solderdemon/rosco_m68k-ramboard/design/roscram01.kicad_pcb

## KiCad design design/roscram01.kicad_pcb (2026-10-20)

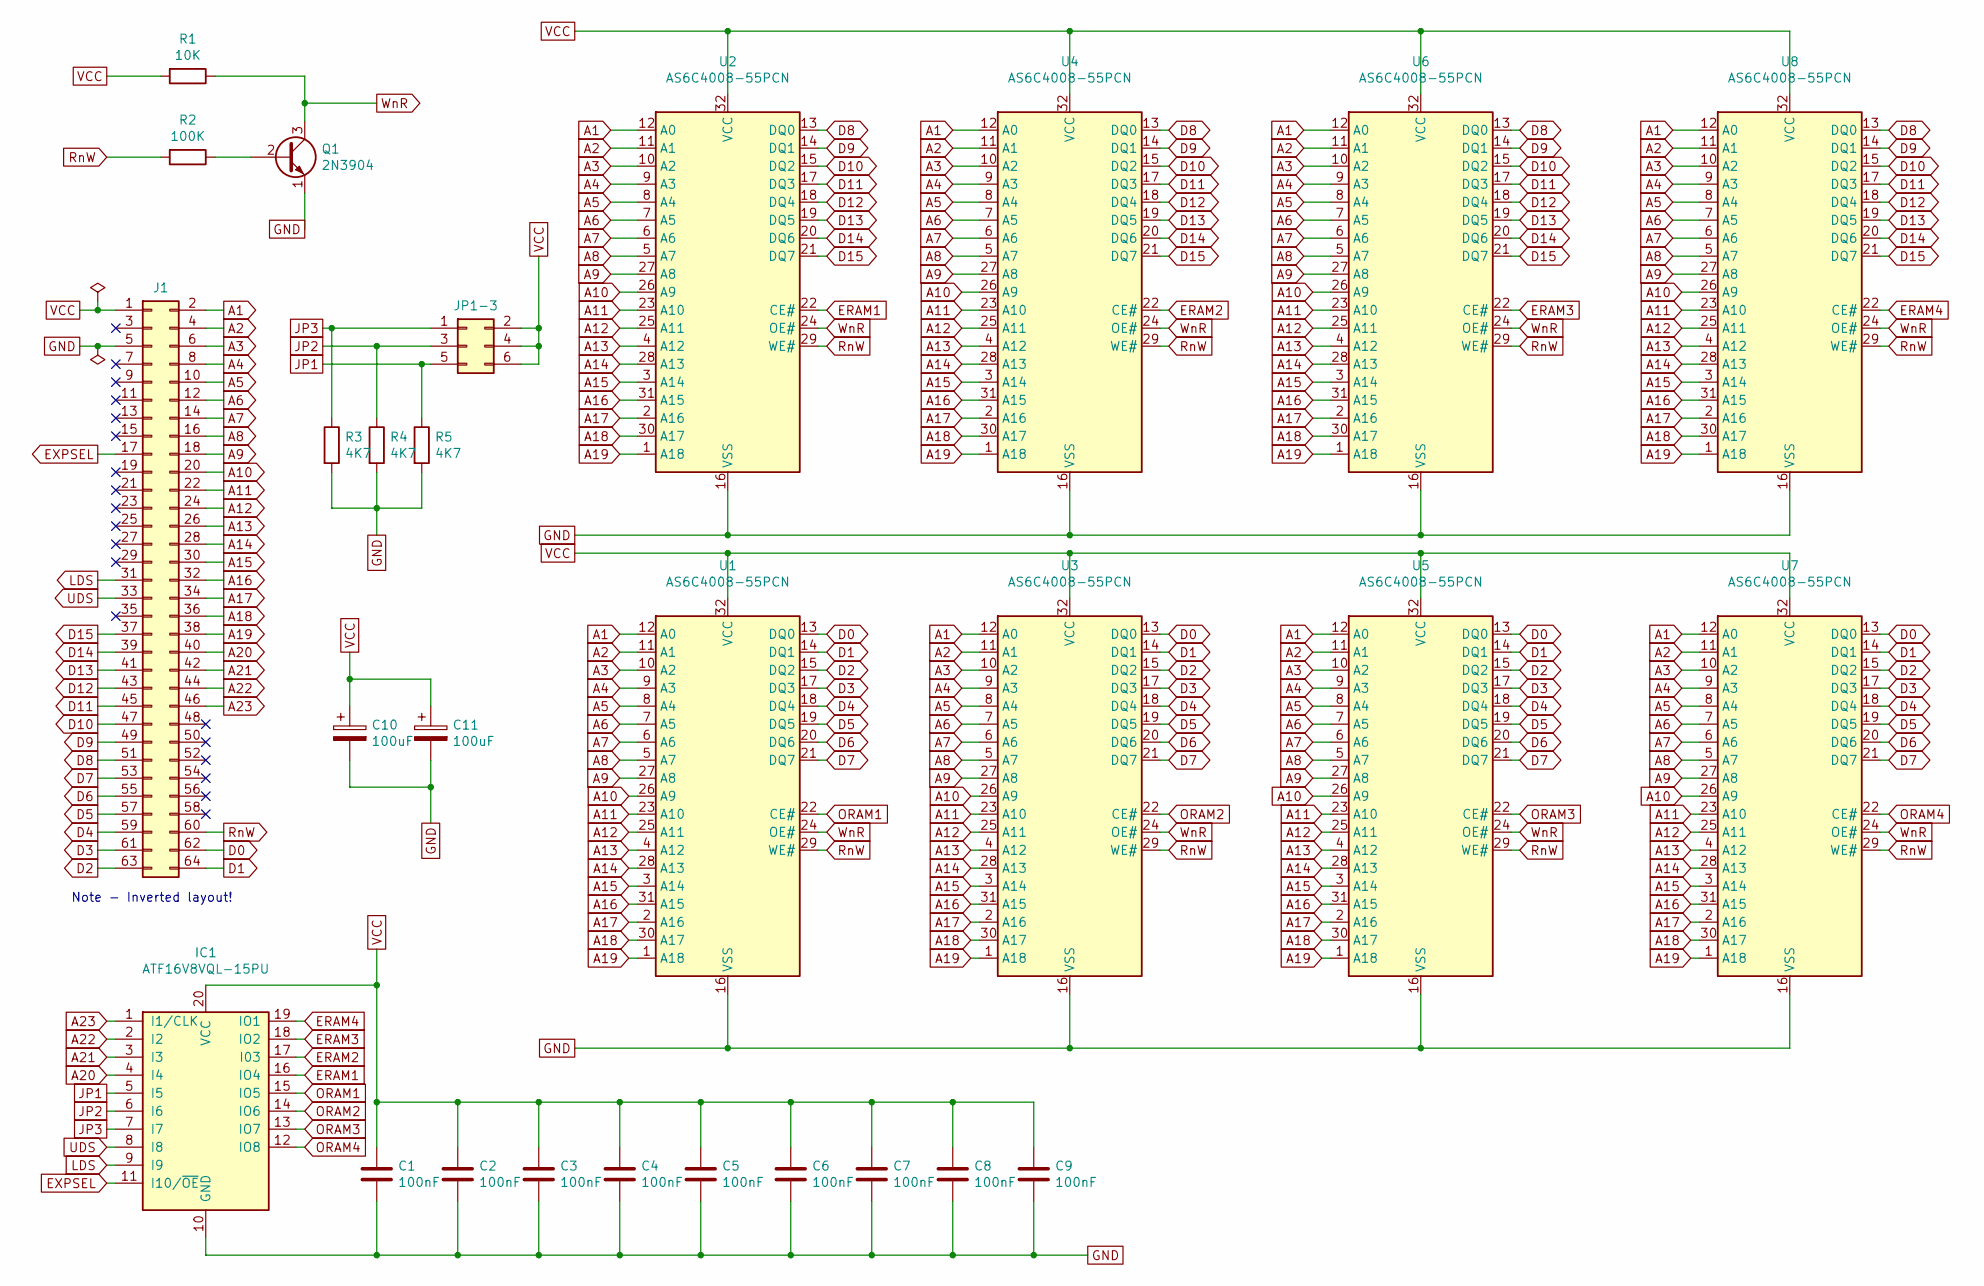
[picture p2: schematic roscram01.sch, rosco_m68k RAM expansion 1]

Parts:
C1, C2, C3, C4, C5, C6, C7, C8, C9: 100nF; C_Radial_5.08mm
C10, C11: 100uF; C-Electolytic-2,5-5
IC1: ATF16V8VQL-15PU; DIL20
J1: Conn_02x32_Odd_Even; pin-2X32
JP1-3: Conn_02x03_Odd_Even; pin-2X3
Q1: 2N3904; TO-92_Inline
R1: 10K; R-0207_10
R2: 100K; R-0207_10
R3, R4, R5: 4K7; R-0207_10
U1, U2, U3, U4, U5, U6, U7, U8: AS6C4008-55PCN; DIP-32_W15.24mm

Connections:
A1: J1.2, U1.12 (A0), U2.12 (A0), U3.12 (A0), U4.12 (A0), U5.12 (A0), U6.12 (A0), U7.12 (A0), U8.12 (A0)
A2: J1.4, U1.11 (A1), U2.11 (A1), U3.11 (A1), U4.11 (A1), U5.11 (A1), U6.11 (A1), U7.11 (A1), U8.11 (A1)
A3: J1.6, U1.10 (A2), U2.10 (A2), U3.10 (A2), U4.10 (A2), U5.10 (A2), U6.10 (A2), U7.10 (A2), U8.10 (A2)
A4: J1.8, U1.9 (A3), U2.9 (A3), U3.9 (A3), U4.9 (A3), U5.9 (A3), U6.9 (A3), U7.9 (A3), U8.9 (A3)
A5: J1.10, U1.8 (A4), U2.8 (A4), U3.8 (A4), U4.8 (A4), U5.8 (A4), U6.8 (A4), U7.8 (A4), U8.8 (A4)
A6: J1.12, U1.7 (A5), U2.7 (A5), U3.7 (A5), U4.7 (A5), U5.7 (A5), U6.7 (A5), U7.7 (A5), U8.7 (A5)
A7: J1.14, U1.6 (A6), U2.6 (A6), U3.6 (A6), U4.6 (A6), U5.6 (A6), U6.6 (A6), U7.6 (A6), U8.6 (A6)
A8: J1.16, U1.5 (A7), U2.5 (A7), U3.5 (A7), U4.5 (A7), U5.5 (A7), U6.5 (A7), U7.5 (A7), U8.5 (A7)
A9: J1.18, U1.27 (A8), U2.27 (A8), U3.27 (A8), U4.27 (A8), U5.27 (A8), U6.27 (A8), U7.27 (A8), U8.27 (A8)
A10: J1.20, U1.26 (A9), U2.26 (A9), U3.26 (A9), U4.26 (A9), U5.26 (A9), U6.26 (A9), U7.26 (A9), U8.26 (A9)
A11: J1.22, U1.23 (A10), U2.23 (A10), U3.23 (A10), U4.23 (A10), U5.23 (A10), U6.23 (A10), U7.23 (A10), U8.23 (A10)
A12: J1.24, U1.25 (A11), U2.25 (A11), U3.25 (A11), U4.25 (A11), U5.25 (A11), U6.25 (A11), U7.25 (A11), U8.25 (A11)
A13: J1.26, U1.4 (A12), U2.4 (A12), U3.4 (A12), U4.4 (A12), U5.4 (A12), U6.4 (A12), U7.4 (A12), U8.4 (A12)
A14: J1.28, U1.28 (A13), U2.28 (A13), U3.28 (A13), U4.28 (A13), U5.28 (A13), U6.28 (A13), U7.28 (A13), U8.28 (A13)
A15: J1.30, U1.3 (A14), U2.3 (A14), U3.3 (A14), U4.3 (A14), U5.3 (A14), U6.3 (A14), U7.3 (A14), U8.3 (A14)
A16: J1.32, U1.31 (A15), U2.31 (A15), U3.31 (A15), U4.31 (A15), U5.31 (A15), U6.31 (A15), U7.31 (A15), U8.31 (A15)
A17: J1.34, U1.2 (A16), U2.2 (A16), U3.2 (A16), U4.2 (A16), U5.2 (A16), U6.2 (A16), U7.2 (A16), U8.2 (A16)
A18: J1.36, U1.30 (A17), U2.30 (A17), U3.30 (A17), U4.30 (A17), U5.30 (A17), U6.30 (A17), U7.30 (A17), U8.30 (A17)
A19: J1.38, U1.1 (A18), U2.1 (A18), U3.1 (A18), U4.1 (A18), U5.1 (A18), U6.1 (A18), U7.1 (A18), U8.1 (A18)
A20: IC1.4 (I4), J1.40
A21: IC1.3 (I3), J1.42
A22: IC1.2 (I2), J1.44
A23: IC1.1 (I1/CLK), J1.46
D0: J1.62, U1.13 (DQ0), U3.13 (DQ0), U5.13 (DQ0), U7.13 (DQ0)
D1: J1.64, U1.14 (DQ1), U3.14 (DQ1), U5.14 (DQ1), U7.14 (DQ1)
D2: J1.63, U1.15 (DQ2), U3.15 (DQ2), U5.15 (DQ2), U7.15 (DQ2)
D3: J1.61, U1.17 (DQ3), U3.17 (DQ3), U5.17 (DQ3), U7.17 (DQ3)
D4: J1.59, U1.18 (DQ4), U3.18 (DQ4), U5.18 (DQ4), U7.18 (DQ4)
D5: J1.57, U1.19 (DQ5), U3.19 (DQ5), U5.19 (DQ5), U7.19 (DQ5)
D6: J1.55, U1.20 (DQ6), U3.20 (DQ6), U5.20 (DQ6), U7.20 (DQ6)
D7: J1.53, U1.21 (DQ7), U3.21 (DQ7), U5.21 (DQ7), U7.21 (DQ7)
D8: J1.51, U2.13 (DQ0), U4.13 (DQ0), U6.13 (DQ0), U8.13 (DQ0)
D9: J1.49, U2.14 (DQ1), U4.14 (DQ1), U6.14 (DQ1), U8.14 (DQ1)
D10: J1.47, U2.15 (DQ2), U4.15 (DQ2), U6.15 (DQ2), U8.15 (DQ2)
D11: J1.45, U2.17 (DQ3), U4.17 (DQ3), U6.17 (DQ3), U8.17 (DQ3)
D12: J1.43, U2.18 (DQ4), U4.18 (DQ4), U6.18 (DQ4), U8.18 (DQ4)
D13: J1.41, U2.19 (DQ5), U4.19 (DQ5), U6.19 (DQ5), U8.19 (DQ5)
D14: J1.39, U2.20 (DQ6), U4.20 (DQ6), U6.20 (DQ6), U8.20 (DQ6)
D15: J1.37, U2.21 (DQ7), U4.21 (DQ7), U6.21 (DQ7), U8.21 (DQ7)
ERAM1: IC1.16 (IO4), U2.22 (CE#)
ERAM2: IC1.17 (I03), U4.22 (CE#)
ERAM3: IC1.18 (IO2), U6.22 (CE#)
ERAM4: IC1.19 (IO1), U8.22 (CE#)
EXPSEL: IC1.11 (I10/~OE~), J1.17
JP1: IC1.5 (I5), JP1-3.5, R5.1
JP2: IC1.6 (I6), JP1-3.3, R4.1
JP3: IC1.7 (I7), JP1-3.1, R3.1
LDS: IC1.9 (I9), J1.31
unnamed: Q1.2 (B), R2.1
ORAM1: IC1.15 (IO5), U1.22 (CE#)
ORAM2: IC1.14 (IO6), U3.22 (CE#)
ORAM3: IC1.13 (IO7), U5.22 (CE#)
ORAM4: IC1.12 (IO8), U7.22 (CE#)
RnW: J1.60, R2.2, U1.29 (WE#), U2.29 (WE#), U3.29 (WE#), U4.29 (WE#), U5.29 (WE#), U6.29 (WE#), U7.29 (WE#), U8.29 (WE#)
UDS: IC1.8 (I8), J1.33
WnR: Q1.3 (C), R1.1, U1.24 (OE#), U2.24 (OE#), U3.24 (OE#), U4.24 (OE#), U5.24 (OE#), U6.24 (OE#), U7.24 (OE#), U8.24 (OE#)

Notes on the sheet:
Note - Inverted layout!

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
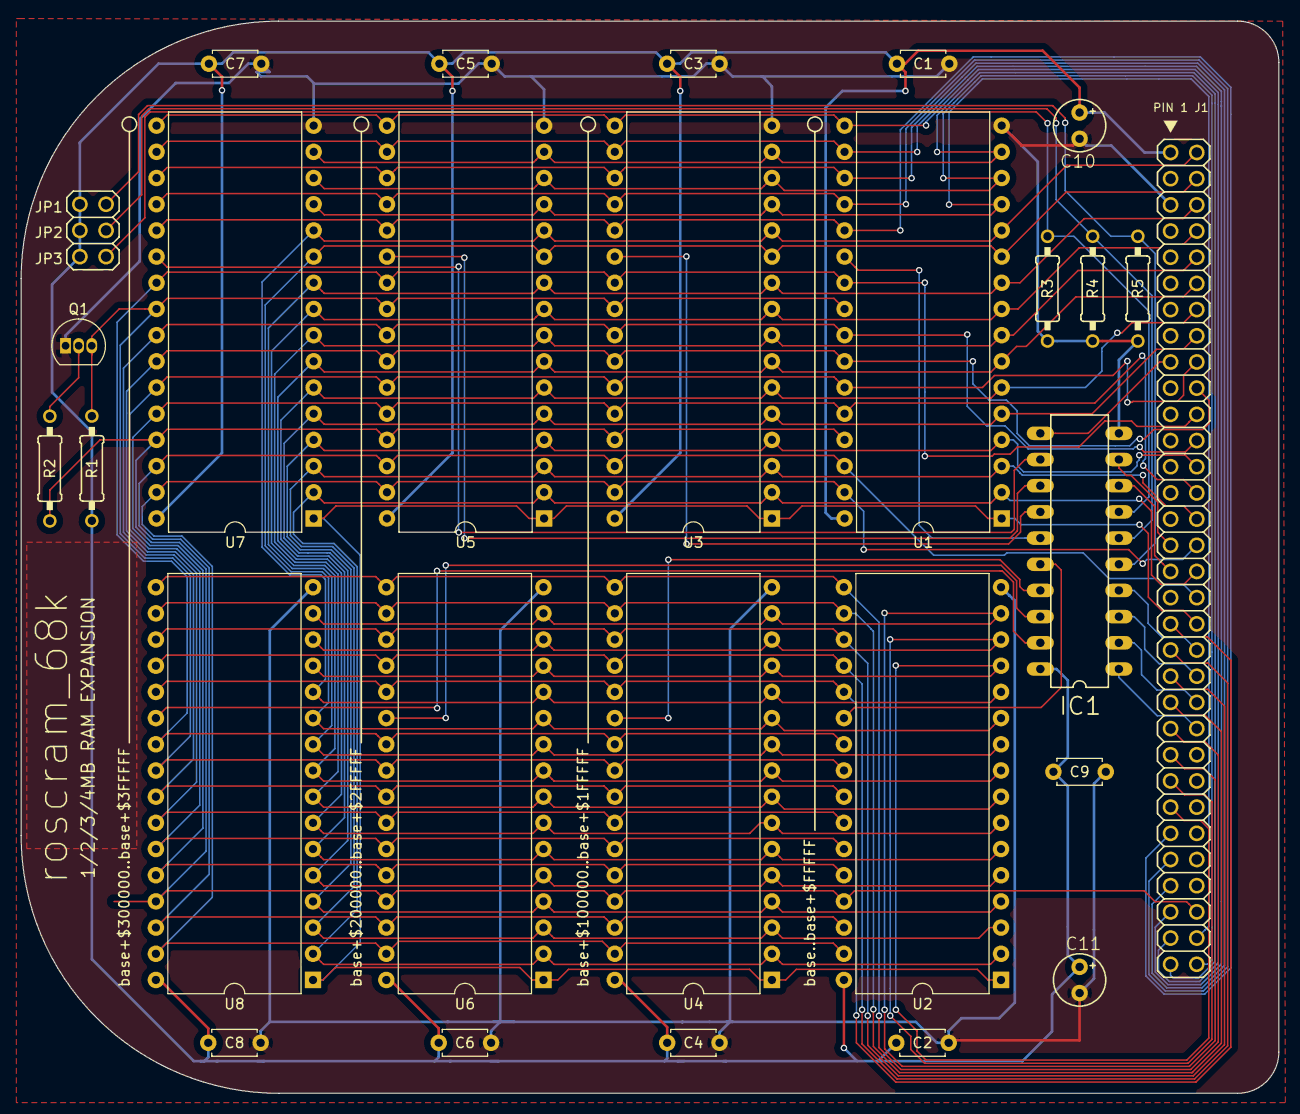
[picture p3: board roscram01.kicad_pcb from above]

Board: 2 copper layers, 122.0 x 104.0 mm, 28 parts (0 on the bottom side), 58 nets.
