solderdemon/rosco_m68k-ramboard/(commit log)

2026-10-20 roscram-01 RAM expansion, SolderDemon revision r1
    Upstream roscram-01 (rosco-m68k/hardware-projects, CERN OHL v1.2) with the
    board brought in line with the SolderDemon m68k cards:
    - nine 100 nF capacitors on the 5.08 mm radial footprint
    (tools/migrate_100nf.py; library vendored in tools/capacitors)
    - every decoupling capacitor on the centre line of its chip, C10/C11 on
    the IC1 axis; the D0-D7 bend at U1 and D8/D9 at U2 re-routed to make
    room, U2 pin 32 on its own via (tools/align_capacitors.py)
    - PIN 1 pointer and J1 designator as on the gpio card
    (tools/add_pin1_mark.py, tools/silk_notices.py)
    - silkscreen without links and OSHW logo, revision r1, copyright of both
    authors; schem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
    [roscram01-B_Cu.gbr, roscram01-B_Mask.gbr, roscram01-B_Paste.gbr, roscram01-B_SilkS.gbr, roscram01-Edge_Cuts.gbr, roscram01-F_Cu.gbr, roscram01-F_Mask.gbr, roscram01-F_Paste.gbr]
2026-10-20 Resistor designators inside the body outline (tools/resistor_refs.py)
    [roscram01.kicad_pcb]
