solderdemon/rosco_m68k-ramboard/(notices)

Notices in the files:
design/roscram01.sch:
Open-Source Hardware licenced under the CERN Open Hardware Licence
Copyright ©2020 Ross Bamford and Contributors; ©2026 SolderDemon
design/roscram01.kicad_pcb:
© 2020 Ross Bamford & Contributors · © 2026 SolderDemon
